Gyuhub/Segway/README.md

# Segway
2020년 후반기 작품 - Cortex M4를 이용한 two wheeled balancing robot
## System Architecture

## Segway
Segway2_3

## Controller
Segway_Controller

## Video 1
ezgif com-gif-maker
## Video 2
ezgif com-gif-maker (1)
