Gyuhub/Segway/Segway/main.c

/**
  ******************************************************************************
  * @file           : main.c
  * @brief          : Main program body
  ******************************************************************************
  ** This notice applies to any and all portions of this file
  * that are not between comment pairs USER CODE BEGIN and
  * USER CODE END. Other portions of this file, whether 
  * inserted by the user or by software development tools
  * are owned by their respective copyright owners.
  *
  * COPYRIGHT(c) 2020 STMicroelectronics
  *
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
  ******************************************************************************
  */
/* Includes ------------------------------------------------------------------*/
#include "main.h"
#include "stm32f4xx_hal.h"

/* USER CODE BEGIN Includes */
#include "stdlib.h"
#include "stdio.h"
/* USER CODE END Includes */

TIM_HandleTypeDef htim2;
TIM_HandleTypeDef htim3;
TIM_HandleTypeDef htim4;
TIM_HandleTypeDef htim9;

UART_HandleTypeDef huart1;
UART_HandleTypeDef huart2;
UART_HandleTypeDef huart6;
DMA_HandleTypeDef hdma_usart1_rx;
DMA_HandleTypeDef hdma_usart6_rx;
DMA_HandleTypeDef hdma_usart6_tx;

/* USER CODE BEGIN PV */
int cnt;
int cnt2;
int cnt3;
int cnt4;
int time=3;
int Pin_State;
int Pin_State_L;
volatile int cma=0;
volatile int idx=0;
volatile int iRoll;
volatile int iYaw;
int Linearity=1;
int stayflag=0;
int spinflagL=0;
int spinflagML=0;
int spinflagR=0;
int spinflagMR=0;
int moveflagF=0;
int moveflagMF=0;
int moveflagB=0;
int moveflagMB=0;
int stableflag=0;
int tiltflag=0;

volatile int JRefThetaDot;
volatile int JThetaDot;
volatile int JTargetRoll;

volatile double dRoll;
volatile double dYaw;
volatile double PreYaw;
volatile double ErrPYaw;
volatile double RefYawDot;
volatile double RollDot;
volatile double RollDDot;
volatile double YawDot;
volatile double pYawDot;
volatile double YawDDot;
volatile double RefYawDot;
volatile double ThetaDot;
volatile double ThetaDDot;
volatile double ThetaDot2;
volatile double ThetaDDot2;
volatile double RefThetaDot;
volatile double PThetaDot;
volatile double TargetRoll=0.0;
volatile double ErrRoll;
volatile double PreErrRoll;
volatile double DeltaErrRoll=0;
volatile double TargetYaw=0.0;
volatile double ErrYawDot;
volatile double ErrSumYawDot;
volatile double PIYawDot;
volatile double ErrYawDDot;
volatile double ErrSumYawDDot;
volatile double PIYawDDot;
volatile double TargetSpeed;
volatile double TargetSpeed2;
volatile double TargetAccel;
volatile double TargetAccel2;
volatile double ErrVelocity;
volatile double ErrSpeed;
volatile double ErrAccel;
volatile double ErrSumSpeed=0;
volatile double ErrSumAccel=0;
volatile double ErrSpeed2;
volatile double ErrAccel2;
volatile double ErrSumSpeed2=0;
volatile double ErrSumAccel2=0;
double Kp=0.7; // Last Value = 0.56
double Ki=0.000000000000000001; // Last Value = 0.000000000000000001 0.000000000000000001;
double Kd=1.6; // Last Value = 1.18
double YawKp=1.8;//15
double YawKi=0.000000000000000001;
double KKp=0.045; // 0.007
double KKKp=0.1;//0.5
volatile double PD_out_Roll;
volatile double IP_out_AngleSpeed;
volatile double IP_out_AngleAccel;
volatile double IP_out_AngleSpeed2;
volatile double IP_out_AngleAccel2;

double m=0.15;
double M=2.7;
double R=0.065;
double L=0.1115;
double W=0.33;
double Jw=0.0012675;
double Jpi;
double Jm=0.0001;
double sin[46] = {0.000,0.0175,0.0349,0.0523,0.0698,0.0872,0.1045,0.1219,0.1392,0.1564,0.1736,0.1908,0.2079,0.2250,0.2419,0.2588,0.2756,0.2924,0.3090,0.3256,0.3420,0.3584,0.3746,0.3907,0.4067,0.4226,0.4384,0.4540,0.4695,0.4848,0.5,0.5150,0.5299,0.5446,0.5592,0.5736,0.5878,0.6018,0.6157,0.6293,0.6428,0.6561,0.6691,0.6820,0.6947,0.7071};
double cos[46] = {1.000,0.9998,0.9994,0.9986,0.9976,0.9962,0.9945,0.9925,0.9903,0.9877,0.9848,0.9816,0.9781,0.9744,0.9703,0.9659,0.9613,0.9563,0.9511,0.9455,0.9397,0.9336,0.9272,0.9205,0.9135,0.9063,0.8988,0.8910,0.8829,0.8746,0.8660,0.8572,0.8480,0.8387,0.8290,0.8192,0.8090,0.7986,0.7880,0.7771,0.7660,0.7547,0.7431,0.7314,0.7193,0.7071};
double n=1/14;
double Rm=0.68;
double Kt=0.039;
double Kb=0.062;
double fm=0.00041;
double fw=0;
volatile int Voltage=0;
volatile int Voltage2=0;
volatile int PreVoltage=0;
volatile int PreSpinVoltage=0;
volatile int SpinVoltage=0;
volatile int spinVoltR=0;
volatile int spinVoltL=0;
double alpha = 244.1025641;
double beta = 0.01521102041;
double gamma = 0.000001020408163;
double delta = 0.001327983193;
double varepsilon = 0.001327983193;
double mu = 0.01956825;
double rho = 0.01956722959;
double iota = 0.06517197529;
double kappa = 0.0006639915966;
double lambda = 0.0008069136746;

uint16_t Motor_CCR_R = 0;
uint16_t Motor_CCR_L = 0;
int32_t encoder_cnt_R;
int32_t encoder_R;
int32_t encoder_cnt_L;
int32_t encoder_L;
int32_t Pencoder;
volatile double Distance_L;
volatile double AngleSpeed_L;
volatile double AngleAccel_L;
volatile double Speed_L;
volatile double Speed;
volatile double Pre_Speed;
volatile double Angle_L;
volatile double Pulse_L;
volatile double Distance_R;
volatile double AngleAccel_R;
volatile double Speed_R;
volatile double Angle_R;
volatile double Pulse_R;
volatile double PAngle;

#define RX_BUFFER_SIZE          50
#define RX_BLUETOOTH_SIZE       2
#define PI              3.1415926535897932384626433832795028841

uint8_t tx_buffer[15] = "/r/n";
uint8_t rx_buffer[RX_BUFFER_SIZE];
uint8_t rx_bluetooth[RX_BLUETOOTH_SIZE];
char rx_roll[7];
char rx_yaw[7];

uint8_t tx_len;

/* USER CODE END PV */

void SystemClock_Config(void);
static void MX_GPIO_Init(void);
static void MX_DMA_Init(void);
static void MX_USART2_UART_Init(void);
static void MX_USART1_UART_Init(void);
static void MX_USART6_UART_Init(void);
static void MX_TIM3_Init(void);
static void MX_TIM4_Init(void);
static void MX_TIM9_Init(void);
static void MX_TIM2_Init(void);

void HAL_TIM_MspPostInit(TIM_HandleTypeDef *htim);
                                

/* USER CODE BEGIN PFP */

/* USER CODE END PFP */

/* USER CODE BEGIN 0 */

void HAL_GPIO_EXTI_Callback(uint16_t GPIO_Pin)
{
  if(GPIO_Pin == GPIO_PIN_13)
  {
    HAL_GPIO_TogglePin(LD2_GPIO_Port, LD2_Pin);
  }
}

void HAL_TIM_PeriodElapsedCallback(TIM_HandleTypeDef *htim)
{
  if(htim == &htim9)
  {
    //===================Saturation=============================================
    if(abs(iRoll)>60.0)
    {
      if( rx_buffer[49]=='S')
      {
        for(int i=0; i<sizeof(rx_buffer); i++)
        {
          rx_buffer[i] = 0;
        }
      }
      else
      {
        TIM4->CCR4 = 0; TIM4->CCR1 = 0;
        while(1);
      }
    }
    cnt++;
    cnt2++;
    cnt3++;
    cnt4++;
    //===================Encoder================================================
    encoder_cnt_L = TIM2->CNT;
    encoder_cnt_R = TIM3->CNT;
    if(encoder_cnt_L>30000) {encoder_L = encoder_cnt_L - 30000;}
    else {encoder_L = encoder_cnt_L + 30000;}
    if(encoder_cnt_R>30000) {encoder_R = encoder_cnt_R - 30000;}
    else {encoder_R = encoder_cnt_R + 30000;}
    //===================BT serial==============================================
    if(cnt3==100) // 100ms Bluetooth receive
    {
    //===================BT Flag detect=========================================
      HAL_UART_Receive_DMA(&huart6, rx_bluetooth, RX_BLUETOOTH_SIZE);
      if((rx_bluetooth[0]=='R'))
      {
        spinflagR=1;
        spinflagMR=0;
        spinflagL=0;
        spinflagML=0;
        moveflagF=0;
        moveflagMF=0;
        moveflagB=0;
        moveflagMB=0;
        stayflag=0;
      }
      else if ((rx_bluetooth[0]=='L'))
      {
        spinflagR=0;
        spinflagMR=0;
        spinflagL=1;
        spinflagML=0;
        moveflagF=0;
        moveflagMF=0;
        moveflagB=0;
        moveflagMB=0;
        stayflag=0;
      }
      else if ((rx_bluetooth[0]=='F'))
      {
        spinflagR=0;
        spinflagMR=0;
        spinflagL=0;
        spinflagML=0;
        moveflagF=1;
        moveflagMF=0;
        moveflagB=0;
        moveflagMB=0;
        stayflag=0;
      }
      else if ((rx_bluetooth[0]=='B'))
      {
        spinflagR=0;
        spinflagMR=0;
        spinflagL=0;
        spinflagML=0;
        moveflagF=0;
        moveflagMF=0;
        moveflagB=1;
        moveflagMB=0;
        stayflag=0;
      }
//=======================BT Weighted Flag=======================================
      else if ((rx_bluetooth[0]=='M'))
      {
        if((rx_bluetooth[1]=='R'))
        {
          spinflagR=0;
          spinflagMR=1;
          spinflagL=0;
          spinflagML=0;
          moveflagF=0;
          moveflagMF=0;
          moveflagB=0;
          moveflagMB=0;
          stayflag=0; 
        }
        else if((rx_bluetooth[1]=='L'))
        {
          spinflagR=0;
          spinflagMR=0;
          spinflagL=0;
          spinflagML=1;
          moveflagF=0;
          moveflagMF=0;
          moveflagB=0;
          moveflagMB=0;
          stayflag=0;
        }
        else if((rx_bluetooth[1]=='F'))
        {
          spinflagR=0;
          spinflagMR=0;
          spinflagL=0;
          spinflagML=0;
          moveflagF=0;
          moveflagMF=1;
          moveflagB=0;
          moveflagMB=0;
          stayflag=0;
        }
        else if((rx_bluetooth[1]=='B'))
        {
          spinflagR=0;
          spinflagMR=0;
          spinflagL=0;
          spinflagML=0;
          moveflagF=0;
          moveflagMF=0;
          moveflagB=0;
          moveflagMB=1;
          stayflag=0;
        }
      }
      else 
      {
        spinflagR=0;
        spinflagMR=0;
        spinflagL=0;
        spinflagML=0;
        moveflagF=0;
        moveflagMF=0;
        moveflagB=0;
        moveflagMB=0;
        stayflag=1;
      }
      cnt3=0;
    }
//=======================Speed P Control========================================    
    if(cnt4==27)
    {
      Pencoder = (encoder_L-30000); // 제어주기동안 회전한 encoder pulse
      PAngle = Pencoder/(1064*2*PI); // deltaPulse/분해능*2PI = 제어주기동안 회전한 각도 theta[rad]
      
      PThetaDot = PAngle*1000/27; // 제어주기동안 움직인 각속도 rad/s
      pYawDot = dYaw*1000/27;
      if(moveflagF||moveflagB||moveflagMF||moveflagMB)
      {
        ErrVelocity = RefThetaDot - PThetaDot;
        TargetRoll = KKp*ErrVelocity;
        JRefThetaDot = RefThetaDot;
        JTargetRoll = TargetRoll;
      }
    //===================Spin P Control=========================================
      else if(spinflagR||spinflagL||spinflagMR||spinflagML)
      {
        TargetRoll=0;
        
        ErrPYaw = RefYawDot - pYawDot;
        TargetYaw = dYaw + KKKp*ErrPYaw;
      }
        cnt4=0;
    }
//=======================Outer Loop=============================================
    if(cnt2==9) // 9ms PD control
    {
    //===================EBIMU receive==========================================
    //===================EBIMU reset buffer=====================================
      HAL_UART_Receive_DMA(&huart1, rx_buffer, RX_BUFFER_SIZE);
      if( (rx_buffer[0] != 49) | (rx_buffer[1] != 48) | (rx_buffer[2] != 48) | (rx_buffer[3] != 45) | (rx_buffer[4] != 48) )
      {
        for(int i=0; i<sizeof(rx_buffer); i++)
        {
          rx_buffer[i] = 0;
        }
      }
      else if( rx_buffer[45]=='S')
      {
        for(int i=0; i<sizeof(rx_buffer); i++)
        {
          rx_buffer[i] = 0;
        }
      }
    //===================EBIMU receive==========================================  
      for(int j=4; j<=34; j++)
      {
        
        if(cma==1 && (rx_buffer[j]!=','))
        {
          rx_roll[j-6] = rx_buffer[j];
        }
        if(cma==3 && (rx_buffer[j]!=','))
        {
          rx_yaw[idx] = rx_buffer[j];
          idx++;
        }
        if(rx_buffer[j]==',')
        {
          cma++;
        }
      }
      dRoll = atof(rx_roll);
      iRoll = atoi(rx_roll);
      
      dYaw = atof(rx_yaw);
      iYaw = atoi(rx_yaw);
      
      cma=0;
      idx=0;
    //===================Flag Saturation========================================
      if(iRoll>20 || iRoll<-20)
      {
        spinflagR=0;
        spinflagMR=0;
        spinflagL=0;
        spinflagML=0;
        moveflagF=0;
        moveflagMF=0;
        moveflagB=0;
        moveflagMB=0;
        stayflag=1;
      }
    //===================Flag detect============================================
    //===================Spin Control===========================================
      if(spinflagL)
      {
        RefYawDot = -1.0;
      }
      else if(spinflagR)
      {
        RefYawDot = 1.0;
      }
      else if(spinflagMR)
      {
        RefYawDot = 1.0;
      }
      else if(spinflagML)
      {
        RefYawDot = -1.0;
      }
    //===================Move Control===========================================
      else if(moveflagF)
      {
        KKp = 0.045;
        RefThetaDot = 1.2;
      }
      else if(moveflagB)
      {
        KKp = 0.045;
        RefThetaDot = -1.2;
      }
      else if(moveflagMF)
      {
        KKp = 0.05;
        RefThetaDot = 1.3;
      }
      else if(moveflagMB)
      {
        KKp = 0.05;
        RefThetaDot = -1.3;
      }
      else if(stayflag)
      {
        ErrVelocity=0;
        TargetRoll=0;
        ErrPYaw=0;
        Kp=0.7; // 0.4 0.55
        Ki=0.000000000000000001; // 1.0125 0.000000000000000001
        Kd=1.6; // 0.4 1.15 1.3
      }
      else
      {
        ErrVelocity=0;
        TargetRoll=0;
        ErrPYaw=0;
        Kp=0.7; // 0.4
        Ki=0.000000000000000001; // 1.0125 0.000000000000000001
        Kd=1.6; // 0.4
      }
    //===================PD Position Control====================================
      if (iRoll <= 10) { Linearity = 1; }
      else if (iRoll>10) { Linearity =0; }
      
      ErrRoll = TargetRoll - (dRoll*PI/180);
      DeltaErrRoll = ErrRoll - PreErrRoll;
      PD_out_Roll = Kp*ErrRoll + Kd*DeltaErrRoll;
      
      RollDot = PD_out_Roll*1000/9; // psi dot
      RollDDot = RollDot*1000/9; // psi double dot
      
      PreErrRoll = ErrRoll;
      cnt2=0;
    } // RollDot and RollDDot is computed which are psi_dot and psi_double_dot
//=======================Inner Loop=============================================
    if(cnt==time) // 3ms IP control
    {
    //===================ThetaDot,ThetaDDot=====================================  
      Pulse_L = (encoder_L-30000); // 제어주기동안 회전한 encoder pulse
      Angle_L = Pulse_L/(1064*2*PI); // deltaPulse/분해능*2PI = 제어주기동안 회전한 각도 theta[rad]
      
      Pulse_R = (encoder_R - 30000);
      Angle_R = Pulse_R/(1064*2*PI);
      
      /*//We need not m/s but cm/s
      Distance_L = Angle_L*6.5; // 제어주기동안 움직인 거리 L = theta*r [cm]
      Distance_R = Angle_R*6.5;
      
      Speed_L = Distance_L/time; // 제어주기동안 움직인 속도 v = L/t [cm/s]
      Speed_R = Distance_R/time;*/
      
      ThetaDot = Angle_L*1000/time; // 제어주기동안 움직인 각속도 rad/s
      ThetaDot2 = Angle_R*1000/time;
      
      ThetaDDot = ThetaDot*1000/time; // 제어주기동안 움직인 각가속도 rad/s^2
      ThetaDDot2 = ThetaDot2*1000/time; 
      
    //===================Linearty(when |iRoll|<10)==============================
      if(Linearity)
      {
        //Left
        TargetSpeed = ((beta*ThetaDDot+rho*RollDDot-varepsilon*RollDot)*(-1)/delta+2*Voltage/(alpha*delta));
        TargetAccel = ((rho*RollDDot+delta*ThetaDot-varepsilon*RollDot)*(-1)/beta+2*Voltage/(alpha*beta));
        //Right
        TargetSpeed2 = ((beta*ThetaDDot2+rho*RollDDot-varepsilon*RollDot)*(-1)/delta+2*Voltage/(alpha*delta));
        TargetAccel2 = ((rho*RollDDot+delta*ThetaDot2-varepsilon*RollDot)*(-1)/beta+2*Voltage/(alpha*beta));
      }
      else
      {
        //Left
        TargetSpeed = ((beta*ThetaDDot-gamma*RollDDot-varepsilon*RollDot+mu*((-1)*sin[iRoll]*RollDot*RollDot+cos[iRoll]*RollDDot))*(-1)/delta+2*Voltage/(alpha*delta));
        TargetAccel = ((-gamma*RollDDot+delta*ThetaDot-varepsilon*RollDot+mu*((-1)*sin[iRoll]*RollDot*RollDot+cos[iRoll]*RollDDot))*(-1)/beta+2*Voltage/(alpha*beta));
        //Right
        TargetSpeed2 = ((beta*ThetaDDot2-gamma*RollDDot-varepsilon*RollDot+mu*((-1)*sin[iRoll]*RollDot*RollDot+cos[iRoll]*RollDDot))*(-1)/delta+2*Voltage/(alpha*delta));
        TargetAccel2 = ((-gamma*RollDDot+delta*ThetaDot2-varepsilon*RollDot+mu*((-1)*sin[iRoll]*RollDot*RollDot+cos[iRoll]*RollDDot))*(-1)/beta+2*Voltage/(alpha*beta));
      }// W [rad/s] a [rad/s^2]
    //===================IP Speed Control=======================================
      //Left
      ErrSpeed = TargetSpeed - ThetaDot;
      ErrSumSpeed += ErrSpeed;
      IP_out_AngleSpeed = -Kp*ThetaDot + Ki*ErrSumSpeed; // IP_out_AngleSpeed은 계산을 거친 목표 AngleSpeed W [rad/s]
      
      ErrAccel = TargetAccel - ThetaDDot;
      ErrSumAccel += ErrAccel;
      IP_out_AngleAccel = -Kp*ThetaDDot + Ki*ErrSumAccel; // IP_out_AngleAccel 계산을 거친 목표 AngleAccel a [rad/s^2]
      
      //Right
      ErrSpeed2 = TargetSpeed2 - ThetaDot2;
      ErrSumSpeed2 += ErrSpeed2;
      IP_out_AngleSpeed2 = -Kp*ThetaDot2 + Ki*ErrSumSpeed2; // IP_out_AngleSpeed은 계산을 거친 목표 AngleSpeed W [rad/s]
      
      ErrAccel2 = TargetAccel2 - ThetaDDot2;
      ErrSumAccel2 += ErrAccel2;
      IP_out_AngleAccel2 = -Kp*ThetaDDot2 + Ki*ErrSumAccel2; // IP_out_AngleAccel 계산을 거친 목표 AngleAccel a [rad/s^2]
      
      JThetaDot = IP_out_AngleSpeed;
    //===================Voltage Calculate======================================
      if(Linearity)
      {
        Voltage = (alpha/2*(beta*IP_out_AngleAccel+rho*RollDDot+delta*IP_out_AngleSpeed-varepsilon*RollDot));
        Voltage2 = (alpha/2*(beta*IP_out_AngleAccel2+rho*RollDDot+delta*IP_out_AngleSpeed2-varepsilon*RollDot));
      }
      else
      {
        Voltage = (alpha*(beta*IP_out_AngleAccel-gamma*RollDDot+delta*IP_out_AngleSpeed-varepsilon*RollDot+mu*((-1)*sin[iRoll]*RollDot*RollDot+cos[iRoll]*RollDDot))/2);
        Voltage2 = (alpha*(beta*IP_out_AngleAccel2-gamma*RollDDot+delta*IP_out_AngleSpeed2-varepsilon*RollDot+mu*((-1)*sin[iRoll]*RollDot*RollDot+cos[iRoll]*RollDDot))/2);
      }
    //===================Spin left==============================================
      if(spinflagL||spinflagML)
      {
    //===================Spin Control===========================================
        YawDot = dYaw/time;
        YawDDot = YawDot/time;
      
        ErrYawDot = TargetYaw/time - YawDot;
        ErrSumYawDot += ErrYawDot;
        PIYawDot = YawKp*ErrYawDot + YawKi*ErrSumYawDot; // IPYawDot 계산을 거친 목표 PhiDot
        
        ErrYawDDot = (TargetYaw/time)/time - YawDDot;
        ErrSumYawDDot += ErrYawDDot;
        PIYawDDot = YawKp*ErrYawDDot + YawKi*ErrSumYawDDot; // IPYawDDot 계산을 거친 목표 PhiDDot
        
        SpinVoltage = (iota*PIYawDDot + kappa*PIYawDot)/lambda;
        
        //When Vr and Vl are different
        //spinVoltR = (SpinVoltage+2*Voltage2)/2;
        //spinVoltL = (2*Voltage-SpinVoltage)/2;
        spinVoltR = SpinVoltage;
        spinVoltL = SpinVoltage;
        
        PreSpinVoltage = spinVoltR;
    //===================Spin Direction Control=================================
        if(spinVoltL<0) { spinVoltL = spinVoltL*(-1.0); HAL_GPIO_WritePin(GPIOC,GPIO_PIN_8, GPIO_PIN_SET);} // SpinVoltL이 positive이면 반시계방향으로 바퀴가 회전
        else { HAL_GPIO_WritePin(GPIOC,GPIO_PIN_8, GPIO_PIN_RESET);}
        if(spinVoltR<0) { spinVoltR = spinVoltR*(-1.0); HAL_GPIO_WritePin(GPIOC,GPIO_PIN_9, GPIO_PIN_SET);} // SpinVoltR이 positive이면 반시계방향으로 바퀴가 회전
        else { HAL_GPIO_WritePin(GPIOC,GPIO_PIN_9, GPIO_PIN_RESET);}
      }
    //===================Spin right=============================================
      else if(spinflagR||spinflagMR)
      {
    //===================Spin Control===========================================
        YawDot = dYaw/time;
        YawDDot = YawDot/time;
      
        ErrYawDot = TargetYaw/time - YawDot;
        ErrSumYawDot += ErrYawDot;
        PIYawDot = YawKp*ErrYawDot + YawKi*ErrSumYawDot; // IPYawDot 계산을 거친 목표 PhiDot
        
        ErrYawDDot = (TargetYaw/time)/time - YawDDot;
        ErrSumYawDDot += ErrYawDDot;
        PIYawDDot = YawKp*ErrYawDDot + YawKi*ErrSumYawDDot; // IPYawDDot 계산을 거친 목표 PhiDDot
        
        SpinVoltage = (iota*PIYawDDot + kappa*PIYawDot)/lambda;        
        
        //When Vr and Vl are diffenet
        //spinVoltL = (SpinVoltage+2*Voltage2)/2;
        //spinVoltR = (2*Voltage-SpinVoltage)/2;
        spinVoltR = SpinVoltage;
        spinVoltL = SpinVoltage;

        PreSpinVoltage = spinVoltL;
    //===================Spin Direction Control=================================
        if(spinVoltL<0) { spinVoltL = spinVoltL*(-1.0); HAL_GPIO_WritePin(GPIOC,GPIO_PIN_8, GPIO_PIN_RESET);} // SpinVoltL이 positive이면 반시계방향으로 바퀴가 회전
        else { HAL_GPIO_WritePin(GPIOC,GPIO_PIN_8, GPIO_PIN_SET);}
        if(spinVoltR<0) { spinVoltR = spinVoltR*(-1.0); HAL_GPIO_WritePin(GPIOC,GPIO_PIN_9, GPIO_PIN_RESET);} // SpinVoltR이 positive이면 반시계방향으로 바퀴가 회전
        else { HAL_GPIO_WritePin(GPIOC,GPIO_PIN_9, GPIO_PIN_SET);}
      }
    //===================Voltage Direction Control==============================
      else
      {
        if(Voltage<0) { Voltage = Voltage*(-1.0); HAL_GPIO_WritePin(GPIOC,GPIO_PIN_8, GPIO_PIN_SET); HAL_GPIO_WritePin(GPIOC,GPIO_PIN_9, GPIO_PIN_RESET);} // Voltage가 negative이면 positive로 바꿔준다
        else { HAL_GPIO_WritePin(GPIOC,GPIO_PIN_8, GPIO_PIN_RESET); HAL_GPIO_WritePin(GPIOC,GPIO_PIN_9, GPIO_PIN_SET);}
        if(Voltage2<0) { Voltage2 = Voltage2*(-1.0); HAL_GPIO_WritePin(GPIOC,GPIO_PIN_8, GPIO_PIN_SET); HAL_GPIO_WritePin(GPIOC,GPIO_PIN_9, GPIO_PIN_RESET);} // Voltage가 negative이면 positive로 바꿔준다
        else { HAL_GPIO_WritePin(GPIOC,GPIO_PIN_8, GPIO_PIN_RESET); HAL_GPIO_WritePin(GPIOC,GPIO_PIN_9, GPIO_PIN_SET);}
      }
      PreVoltage = Voltage;
    //===================Spin Voltage Saturation================================
      if(spinflagR||spinflagL||spinflagMR||spinflagML) {if(spinVoltR>3500.0)  {spinVoltR = 3500.0; } if(spinVoltL>3500.0) {spinVoltL = 3500.0;}}// 회전 안정성을 위해 PWM의 최댓값이 1000 그 이상이면 최대로 고정
      else {if(Voltage>4000.0)  {Voltage = 4000.0; } if(Voltage2>4000.0) {Voltage2 = 4000.0;} } // PWM의 최댓값이 3500 그 이상이면 최대로 고정
    //===================Motor PWM input========================================
      //MOTOR CCR CODE
      if(spinflagR||spinflagL||spinflagMR||spinflagML) { TIM4->CCR4 = spinVoltL; TIM4->CCR1 = spinVoltR;}
      else if (moveflagF||moveflagB||moveflagMF||moveflagMB) {TIM4->CCR4 = Voltage; TIM4->CCR1 = Voltage2; }
      else if (stayflag) {TIM4->CCR4 = Voltage; TIM4->CCR1 = Voltage2; }
      else { TIM4->CCR4 = Voltage; TIM4->CCR1 = Voltage2; }
      cnt=0;
      TIM3->CNT=0;
      TIM2->CNT=0;
    }
    //TIM4->CCR1 = Motor_CCR_R;
    //TIM4->CCR4 = Motor_CCR_L;
    //HAL_GPIO_WritePin(GPIOC,GPIO_PIN_8, GPIO_PIN_RESET);
    //HAL_GPIO_WritePin(GPIOC,GPIO_PIN_9, GPIO_PIN_SET);
    
    Pin_State = HAL_GPIO_ReadPin(GPIOC, GPIO_PIN_9);
    Pin_State_L = HAL_GPIO_ReadPin(GPIOC, GPIO_PIN_8);
  }
}

/* USER CODE END 0 */

/**
  * @brief  The application entry point.
  *
  * @retval None
  */
int main(void)
{
  /* MCU Configuration----------------------------------------------------------*/

  /* Reset of all peripherals, Initializes the Flash interface and the Systick. */
  HAL_Init();

  /* Configure the system clock */
  SystemClock_Config();

  /* Initialize all configured peripherals */
  MX_GPIO_Init();
  MX_DMA_Init();
  MX_USART2_UART_Init();
  MX_USART1_UART_Init();
  MX_USART6_UART_Init();
  MX_TIM3_Init();
  MX_TIM4_Init();
  MX_TIM9_Init();
  MX_TIM2_Init();
  /* USER CODE BEGIN 2 */
  HAL_TIM_Base_Start_IT(&htim9);
  
  HAL_TIM_PWM_Start(&htim4, TIM_CHANNEL_1);
  HAL_TIM_PWM_Start(&htim4, TIM_CHANNEL_4);
  HAL_TIMEx_PWMN_Start(&htim4, TIM_CHANNEL_1);
  HAL_TIMEx_PWMN_Start(&htim4, TIM_CHANNEL_4);
  
  HAL_TIM_Encoder_Start(&htim3, TIM_CHANNEL_ALL);
  HAL_TIM_Encoder_Start(&htim2, TIM_CHANNEL_ALL);
  
  HAL_UART_Receive_DMA(&huart1, rx_buffer, RX_BUFFER_SIZE);
  HAL_UART_Receive_DMA(&huart6, rx_buffer, RX_BUFFER_SIZE);
  /* USER CODE END 2 */

  /* Infinite loop */
  /* USER CODE BEGIN WHILE */
  while (1)
  {
    
  /* USER CODE END WHILE */

  /* USER CODE BEGIN 3 */

  }
  /* USER CODE END 3 */

}

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
