Gyuhub/Segway/(commit log)

2021-05-23 Create STL files
2021-05-23 STM32CubeMX project file
2021-05-23 Segway STM32CubeMX main code
2021-05-23 20년도 후반기 작품 제안서 중간발표 자료
