Gyuhub/Segway/(notices)

Notices in the files:
Segway/main.c:
(C) COPYRIGHT STMicroelectronics *****END OF FILE
